TendoPain18/nour-robot-embedded-navigation/documents/_Embedded and Electrical Team Final Presentation.pdf

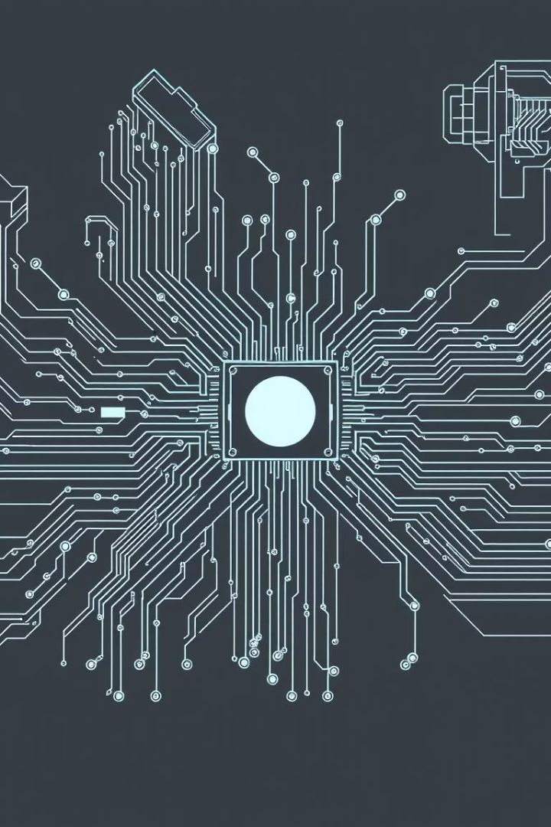
[picture p15: figure]

# Robotics Project Update: Progress to Date

This presentation reviews our progress on the robotics project.

Made By:

Ziad Behairy 202100154
Amr Ashraf 202101355

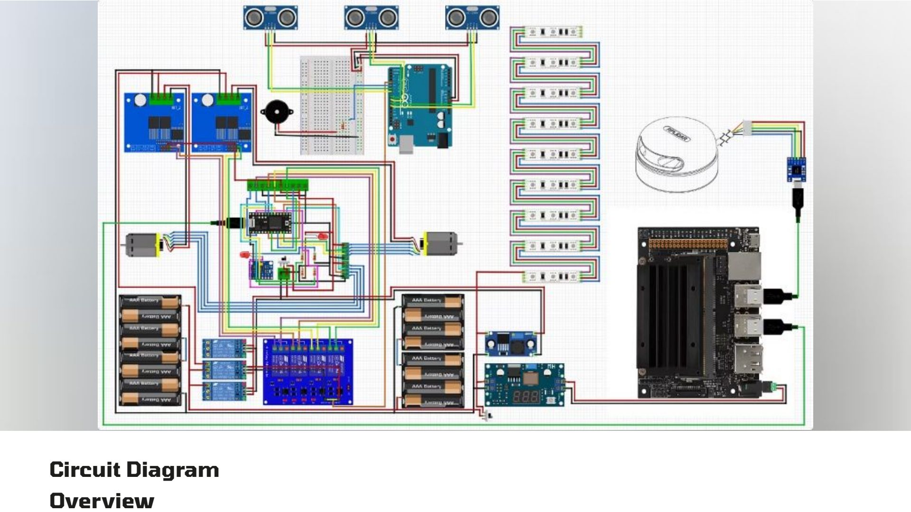
[picture p16: page 2]

## Circuit Diagram Overview

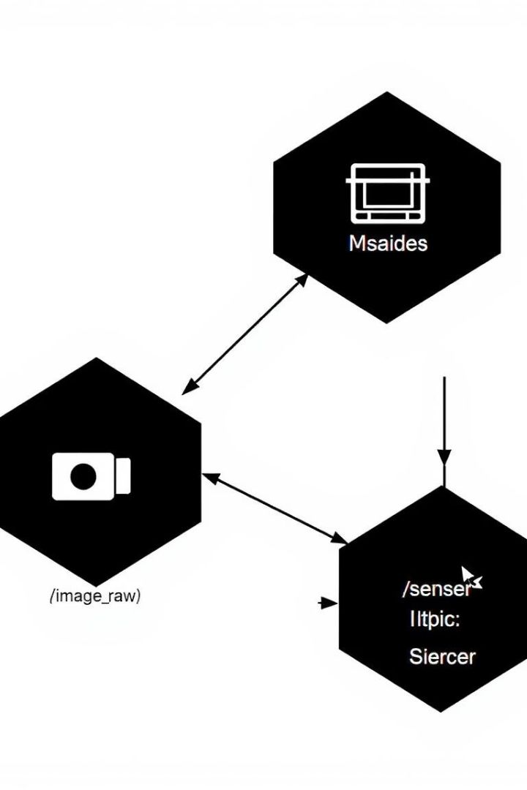
[picture p17: figure]

# Node and Topic Communication Architecture

### ROS Nodes

Modular processes
handling sensing,
planning, and actuation

### Topics

Defined channels for
message exchange
between nodes

### Data Rates

Optimized for real-time performance and reliability

# Node and Topic Communication

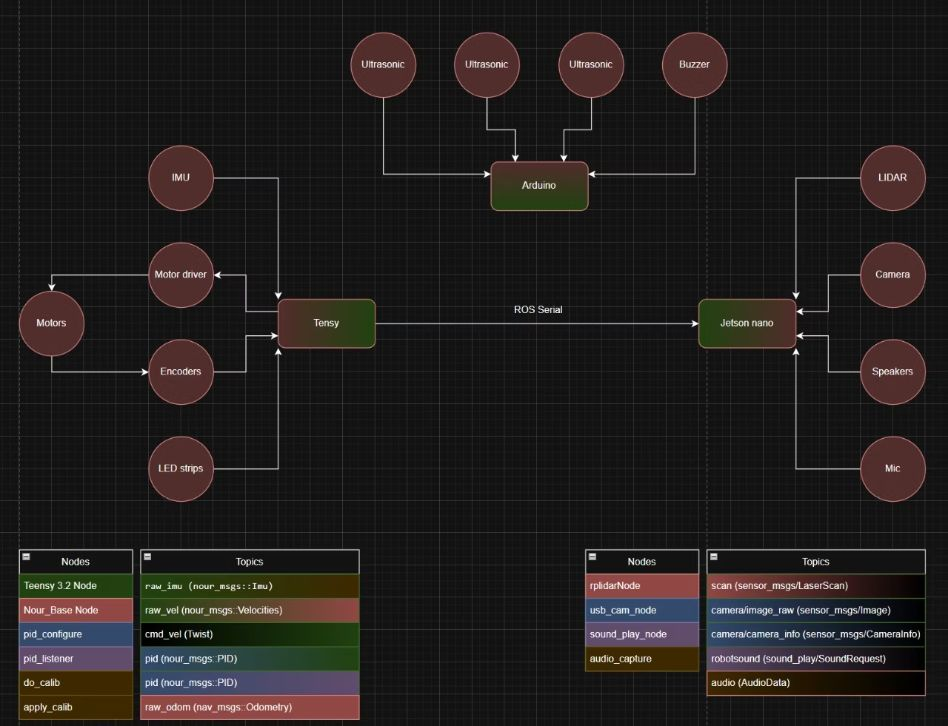
[picture p18: figure]

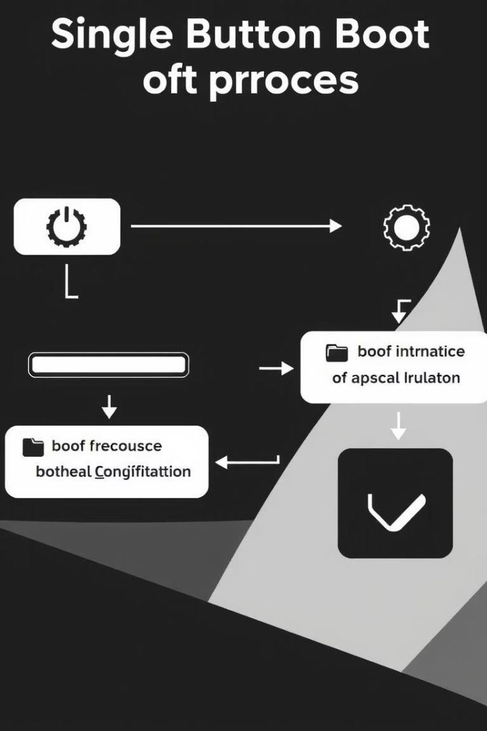
[picture p19: figure]

# Single Button Boot Chart

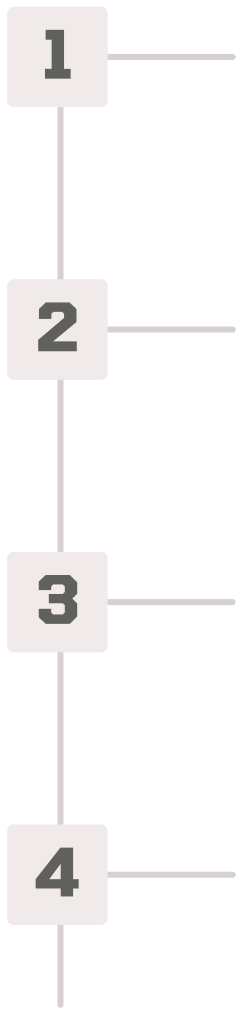
[picture p20: figure]

### 1 Power-On

System starts when the button is pressed

### 2 Self-Diagnostics

Run hardware and software checks

### 3 Initialization

Prepare communication and control modules

### 4 Operational State

Robot ready for tasks

# Single Button Boot

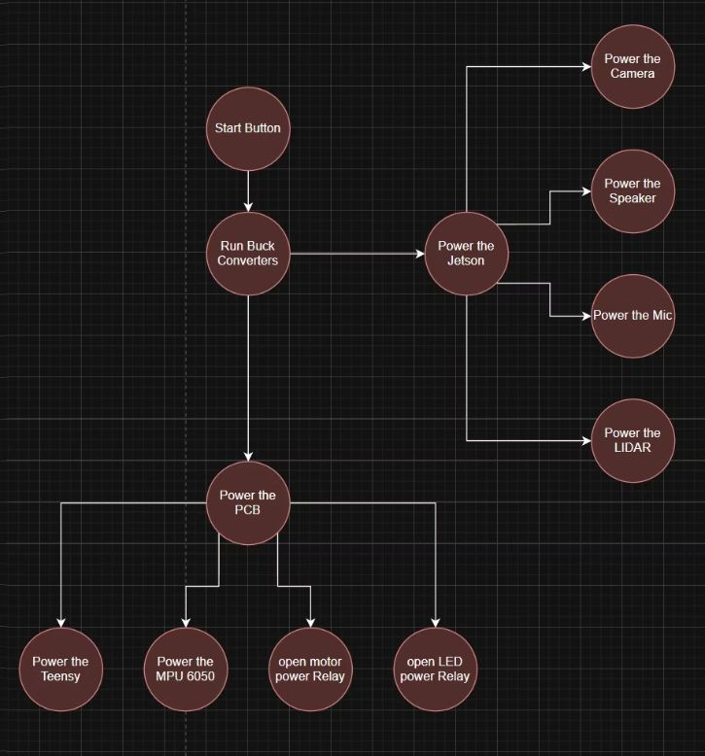
[picture p21: figure]

# Motor Driver Replacement

### Original vs New

- Replaced corrupted driver with two new units
- Improved reliability and performance
- Max amphere

### Physical

Replacement update the code

Updated pin layout to match dual driver setup

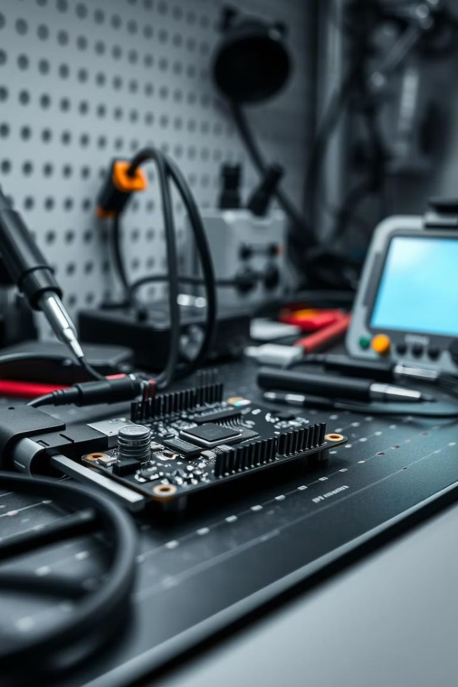
[picture p22: figure]

# Teensy Repair and Recovery

### 1 Issue Identification

Detected corrupted Teensy
firmware causing errors

### 2 Troubleshooting Steps

Used diagnostic tools to
isolate problem

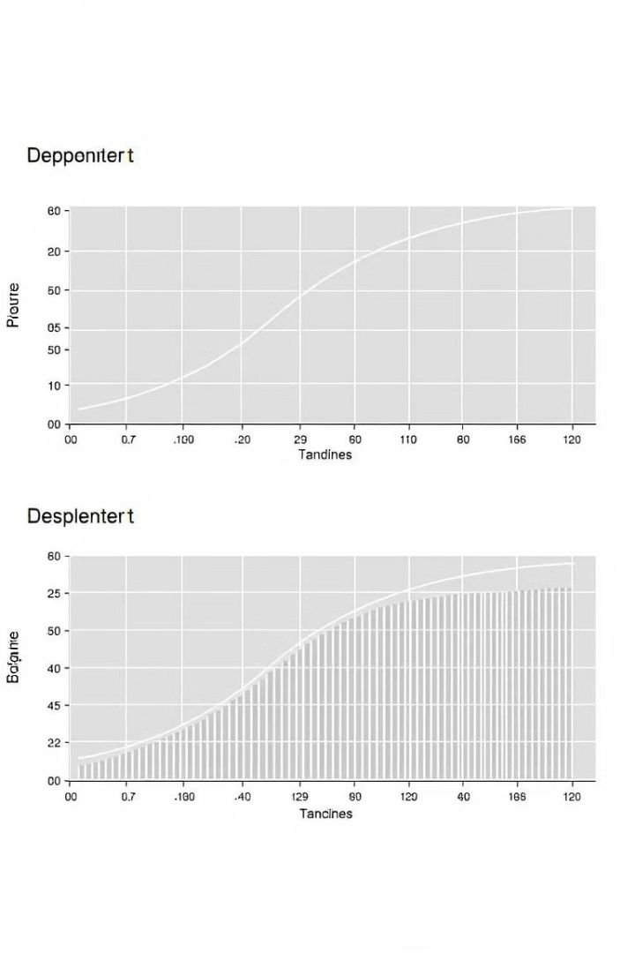
[picture p23: figure]

# PID Constants Optimization

### Corrupted Constants

Initial PID values caused unstable motor control

### Re-Tuning Process

Systematically adjusted Kp, Ki, and Kd values

### Optimized Values

Kp, Ki, Kd improved stability

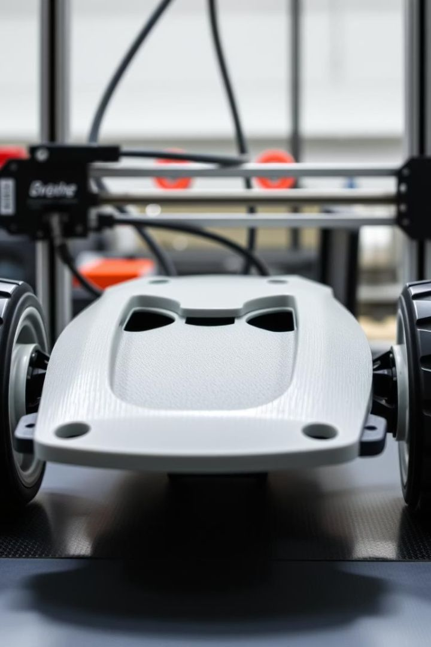
[picture p24: figure]

# Project Achievements and Next Steps

### Speakers

run the speakers with
bluetooth tongle

### RealSense Camera

run it and handle its high power demands

### microphone to detect sounds

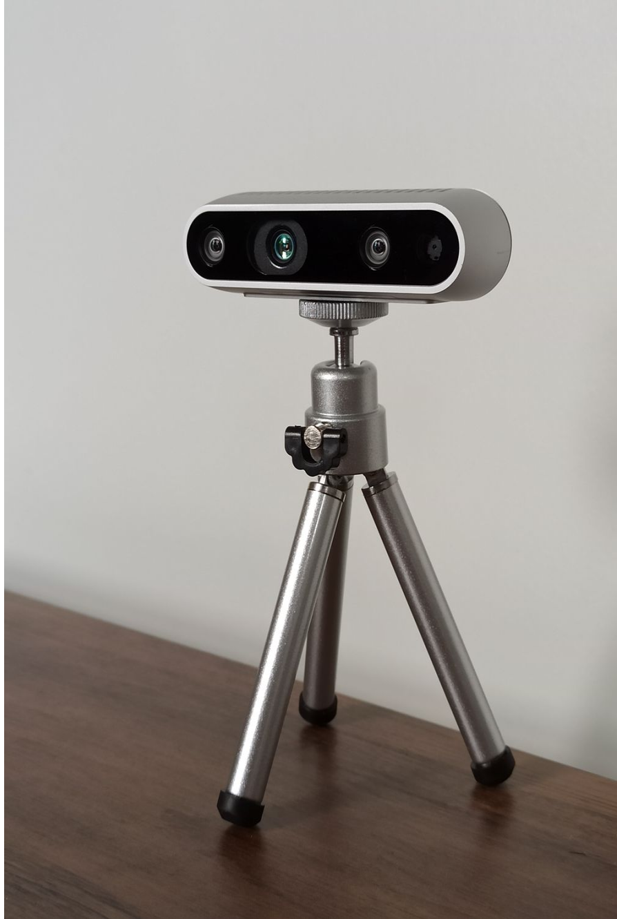
[picture p25: figure]

# RealSense Camera Addition

### 1 Handle power spikes if there

### 2 Testing

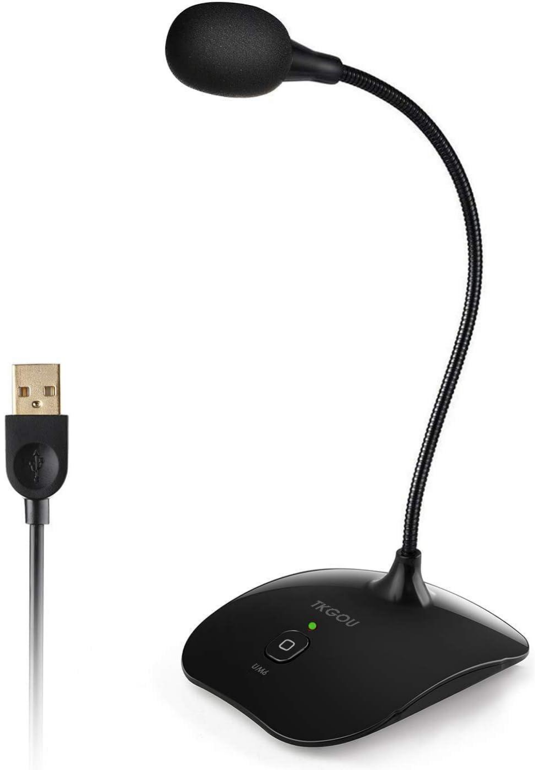
[picture p26: figure]

# Add Microphone

### 1 Good postioning

### 2 Testing

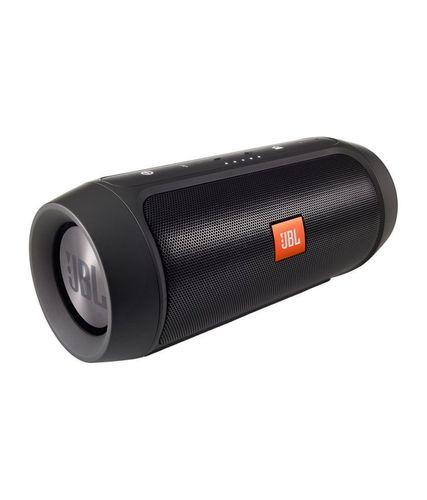
[picture p27: figure]

# Bluetooth Speaker

### 1 Trying use small Bluetooth module

### 2 Use Bluetooth Tongle for the jetson

# Bluetooth Speaker

### 3 Make a node to detect cmd_vel topic for any movement

### 4 testing

# Fix the Arduino emergency stop system

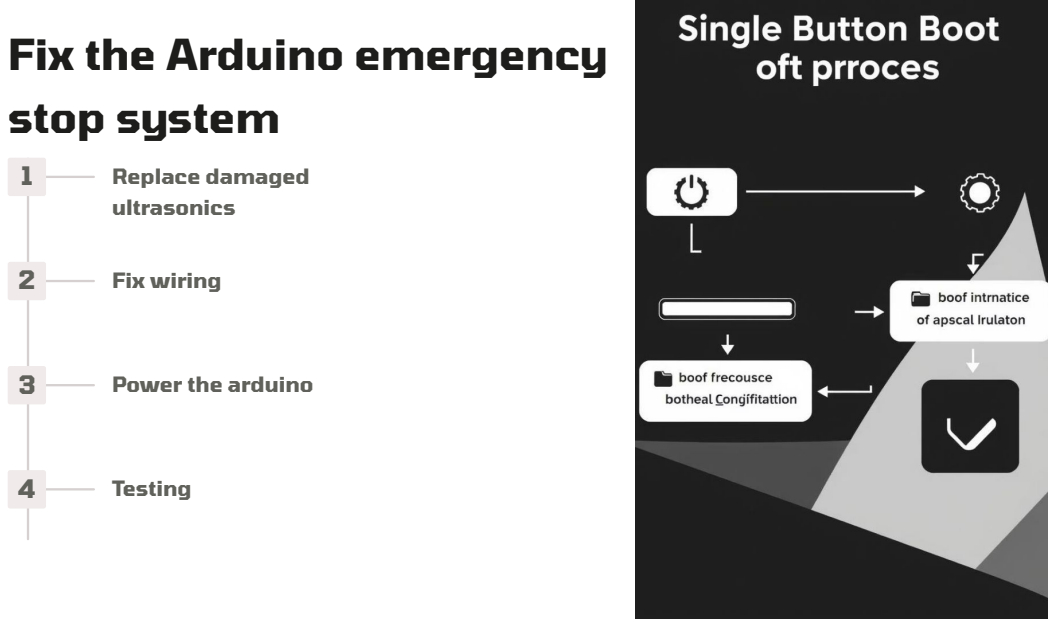
[picture p28: page 15]
1 Replace damaged ultrasonics; 2 Fix wiring; 4 Testing

3 Power the arduino

# Thank YOU
