TendoPain18/nour-robot-embedded-navigation/documents/Phase-1.pdf

"Phase 1: Initial Research and System Foundation"

Each team will focus on understanding the existing system and researching improvements. These first tasks will help lay the groundwork for designing, integrating, and enhancing the robot.

Mechanical and Design Team:
Task:
- Draw the existing robot body (Solidworks)
- Research and propose design ideas for an upper body that is easy to assemble and maintain.
- Define the materials for construction and justify their selection.
- Identify the best way to mount sensors (camera, LiDAR, ultrasonic, infrared) and a screen for emotion display.

Embedded and Electrical Team:
Task:
- List all sensors (Camera, LiDAR, Ultrasonic, Infrared) and define their ROS topics.
- Create a connection diagram for how these sensors will be interfaced with the robot’s hardware.
- Develop a basic ROS node that reads data from at least one sensor (e.g., ultrasonic or infrared).
- Plan the single-button system boot-up and provide a rough system flowchart.

Control and Navigation Team
Task:
- Research and compare SLAM algorithms (e.g., gmapping, slam tool-box)
- Choose the most suitable SLAM algorithm for mapping and localization.
- Explore obstacle avoidance methods and determine the best approach.

AI and Chatbot Team
Task
- Define how the robot will identify users (e.g., face recognition, voice recognition).
- Research available chatbot frameworks (e.g., Rasa, Dialogflow, GPT-based) and suggest one.
- List possible interaction scenarios the robot should handle.
